wannakornGG/Pattern-and-Frequency-Reconfigurable-Meander-Line-Yagi-Uda-Antenna/README.md

# Pattern-and-Frequency-Reconfigurable-Meander-Line-Yagi-Uda-Antenna
